mzilon/Elder-Care-AI/README.md

# Elder-Care-AI
The project files are constantly being revised and uploaded here.
A Quick Demo: https://youtu.be/ah3b0XdRygE
