mzilon/Elder-Care-AI/Kick-off Presentation.pdf

# Nala: Smart Companion for Seniors

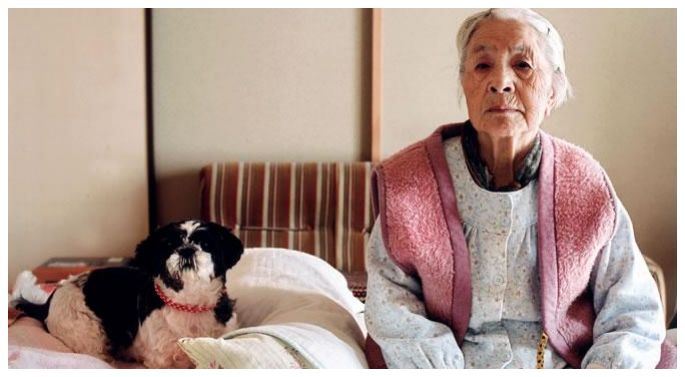
[picture p55: figure]
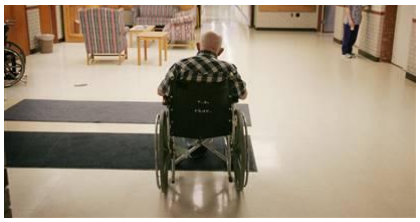
[picture p56: figure]
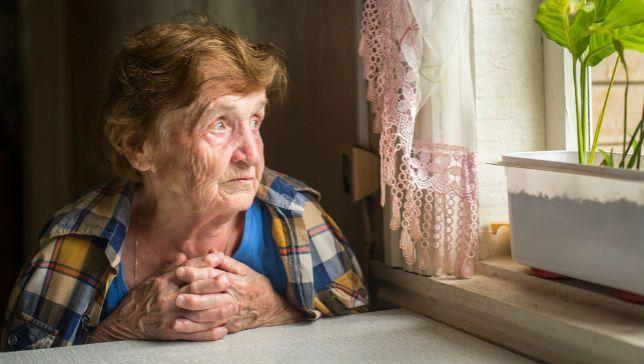
[picture p57: figure]

TEAM: Randy Garcia (Project Manager), Thomas Wilk, Hongyu Shi, Mohammad Zilon, Parmanand Shiwmangal MENTOR: Professor Xiao

# Chapter 1: Introduction

- The idea of smart companion for seniors resonated with us
- Nala is a smart companion for seniors which helps improve the

lives of its users

- The device will be small so that it can fit comfortably in a home

and also be pleasant or cute in appearance

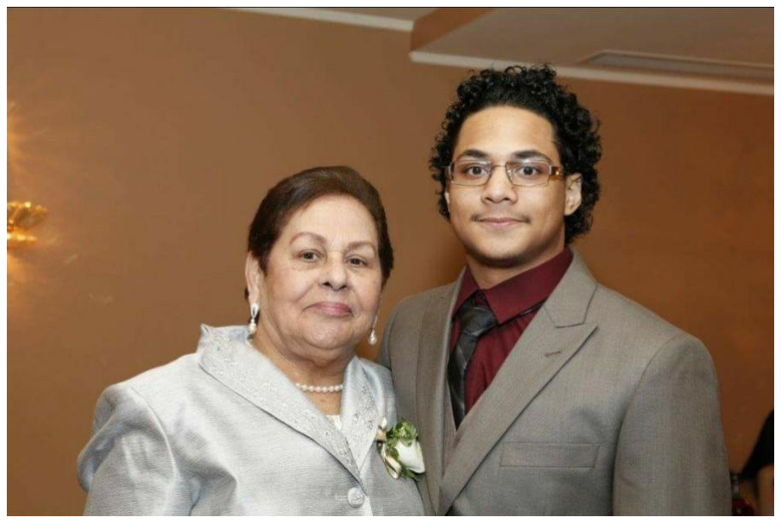
[picture p58: figure]

Image I: Randy wants his grandmother to have all the

support she can get

# Need

- Seniors have become a fast-growing share of the U.S. population. According to projections from the Population Reference Bureau, nearly one in four Americans will be over 65 by 2060. (Source: U.S. Census Bureau)
- Most adults are out working, while their elderly parents are often left alone, or are at a senior care center where they might not be given adequate attention.

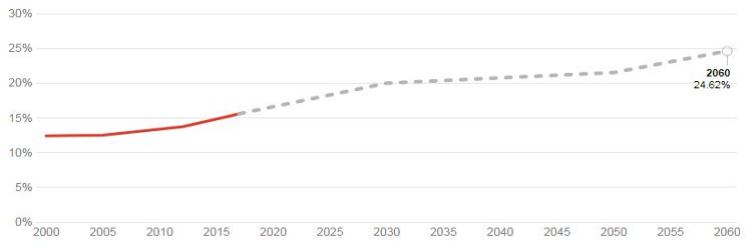
[picture p59: figure]

Need cont.

- Study conducted Selwyn Height retirement home in New Zealand.
- 40 seniors participated in the from ages ranging from 55-100 years.

### - Where a group of 20 interacted Paro for 12 weeks - Compared to the control group the group with Paro were noted to feel less lonely

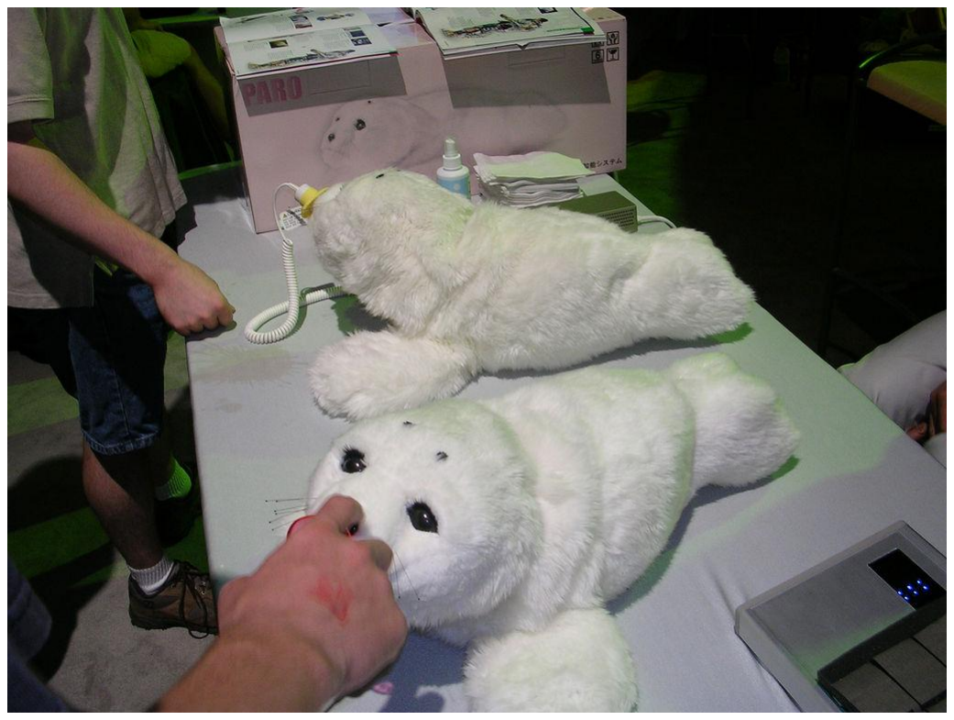
[picture p60: figure]

# Problem

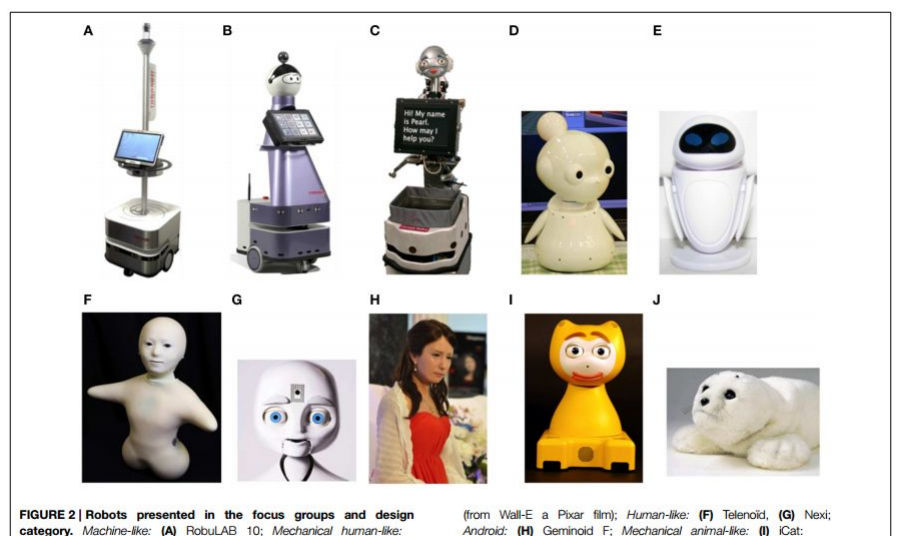
[picture p61: figure]

- The main problem addressed we will be companionship for the elderly.
- So a pleasant appearance, a comfortable size along with a natural way of interacting with our companion are all necessary help to alleviate those feelings of the user being lonely or perhaps forgotten
- The device will support its user by providing reminders, life

alert, and functions for fun. The machine-learning nature of the robot would allow it to create more useful alerts, reminders, and games.

# Business Model Canvas

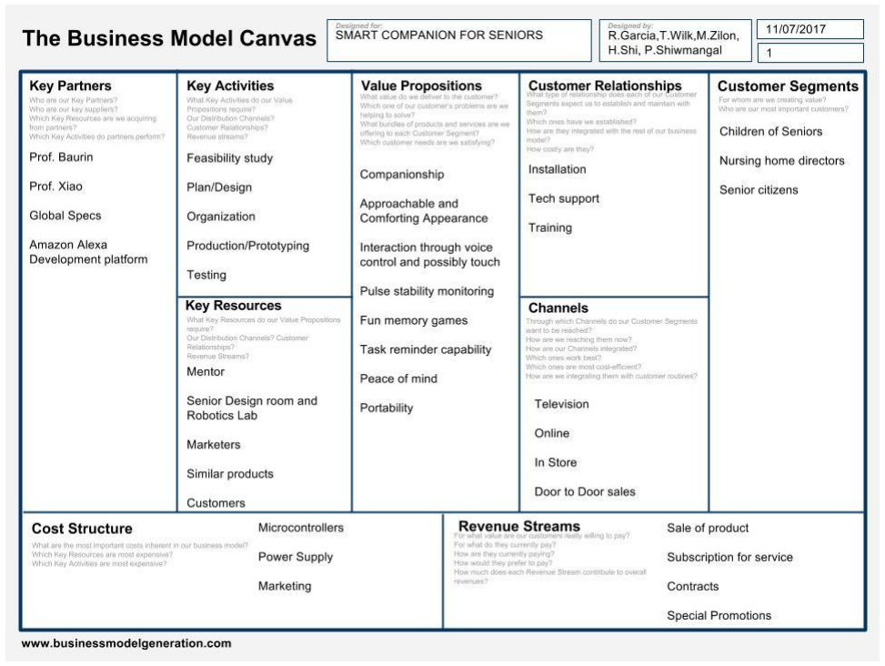
[picture p62: figure]

# External Requirements

Nala’s key external requirements are its functions, safety, operating environment, appearance, robustness and reliability.
Key Functions:
- Companionship (Note it does not replace human companionship),
- Life stability monitoring,
- Task reminding,
- Memory games,
- Motion to aid in appearance and interaction.

The Operating Environment:
- At room temperature of about 20℃ or 68℉ or 293°K.
- To be used indoors such as private homes and nursing homes, though it can be utilized outdoors.
- To be used in stationary condition, such as on top of desks or tables.

External Requirements cont.

Appearance:
- Friendly, approachable, comforting and soothing.

Robustness:
- Internal circuitry protected by metal framework.
- External body encased in polymer.

Reliability:
- Supported by emergency batteries in case there is loss of AC power.
- Nala’s functionality is not dependent on its physical condition. Therefore, its functionality will not degrade even if it is physically damaged.

# Internal Requirements

Marketing

- Phone interviews and face-to-face interviews have been conducted with potential customers to gain insight of their experiences with senior care products, such as devices to keep patients occupied and other unmet needs that can be offered by a companion bot.
- Adults ages 50 to 65 who are providing active care to their elderly parents ages 70 and beyond.
- Ideally receive a government contract requiring our device be installed in all federal and state veteran’s hospitals.

Internal Requirements cont.

Manufacturing

- Essential Parts to be Ordered:
1. 3D printing Filaments,
2. Raspberry Pi 3,
3. Arduino Uno,
4. Bluetooth Pulse Sensor,
5. Stereo Camera,
6. A microphone,
7. 5V Voltage Regulator
8. Continuous Rotation Servos.
- We have options to assemble and test the companion bot in in a studio space in NYC or in Professor Xiao’s Lab Room.

# Restrictions

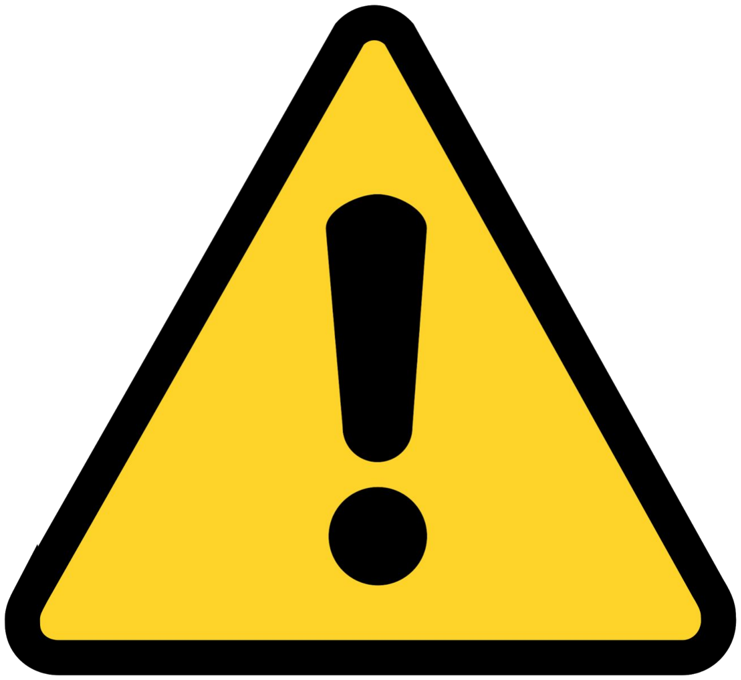
[picture p63: figure]

### - Patent: exists for robotic system to “assist immobile persons”

### - Institutions: respect for others

### - Insurance: UL certification would be need for final product

# Limitations: Environmental limitations affecting the product

### Conductive surfaces insulated

### Voltage regulator to isolate internal parts from wall

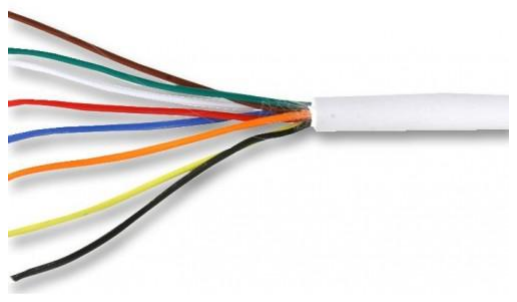
[picture p64: figure]

### voltage

### Air circulates through device body for natural cooling

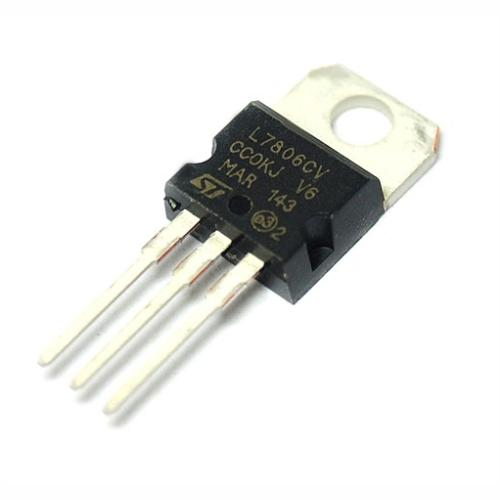
[picture p65: figure]
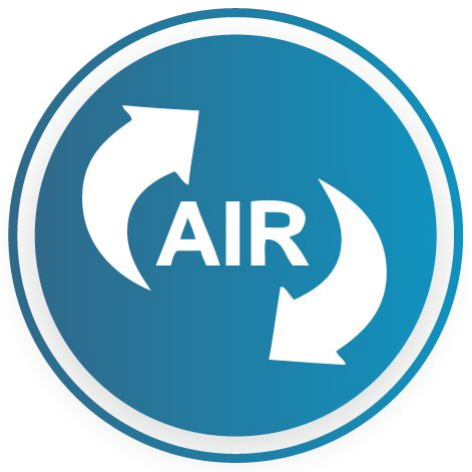
[picture p66: figure]

# Limitations: product affecting the environment

Creates no solid waste | Creates no air pollution | Noise pollution: headphones can be used

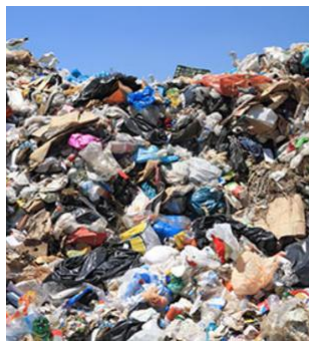
[picture p67: figure]
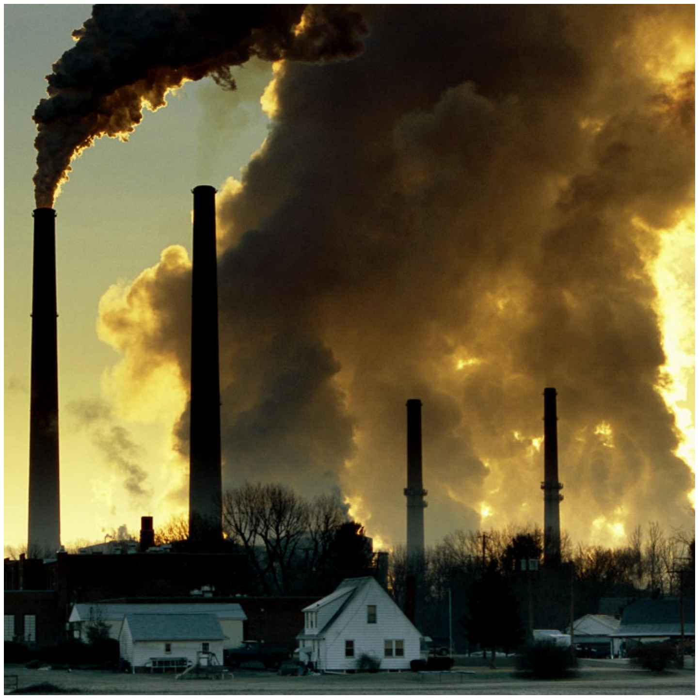
[picture p68: figure]
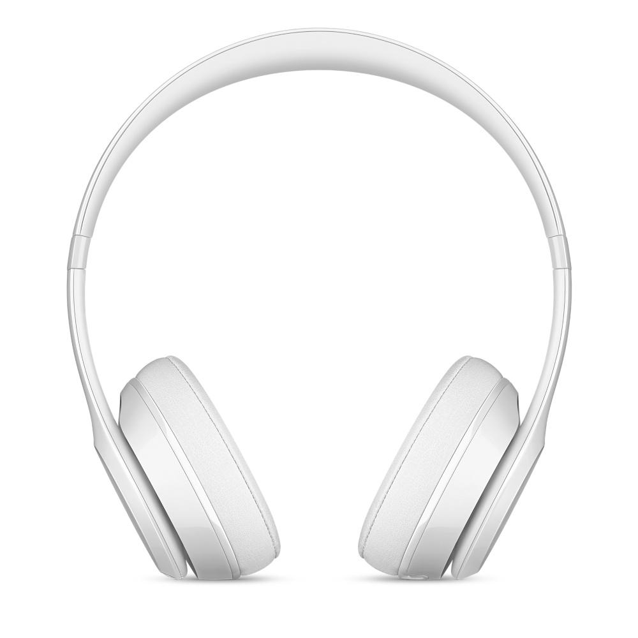
[picture p69: figure]

# Project Charter

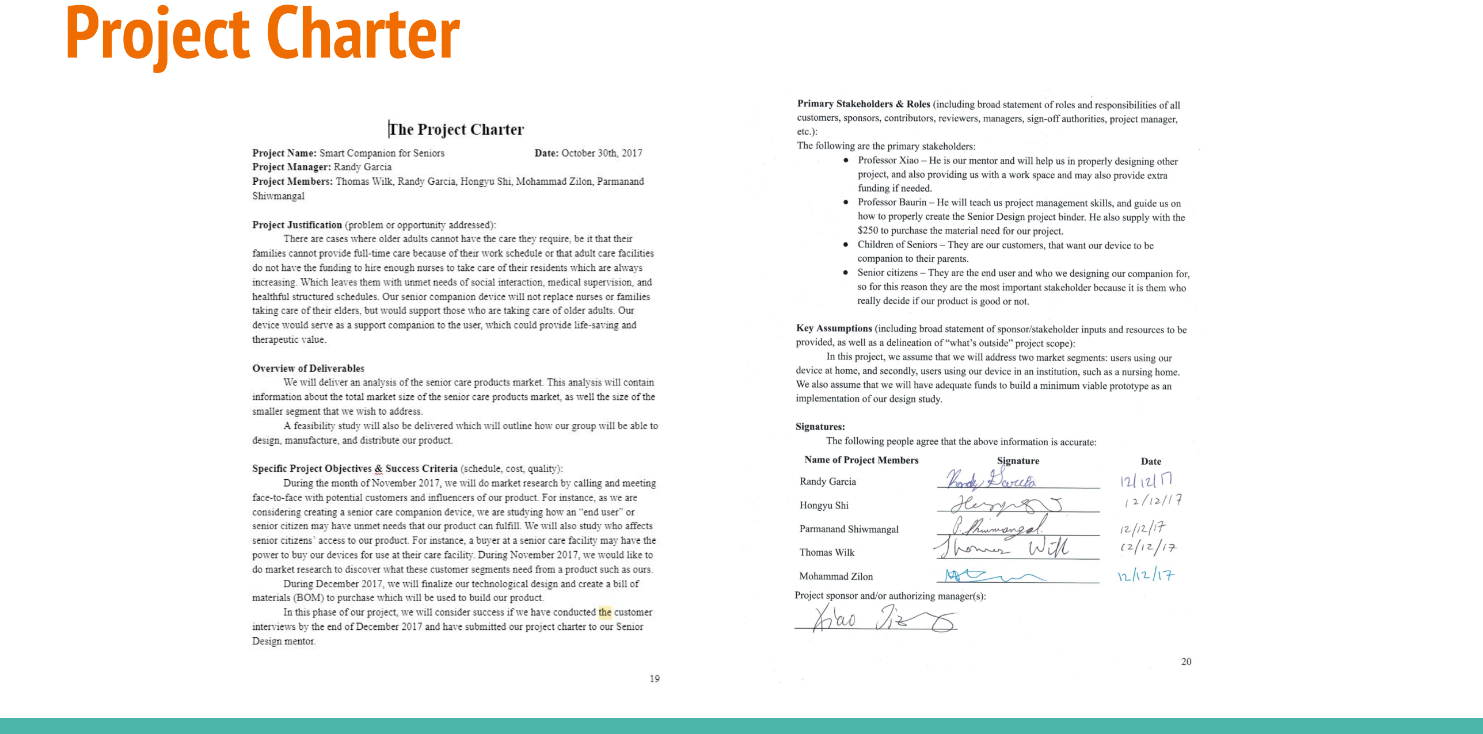
[picture p70: page 14]

# Chapter 2: Planning

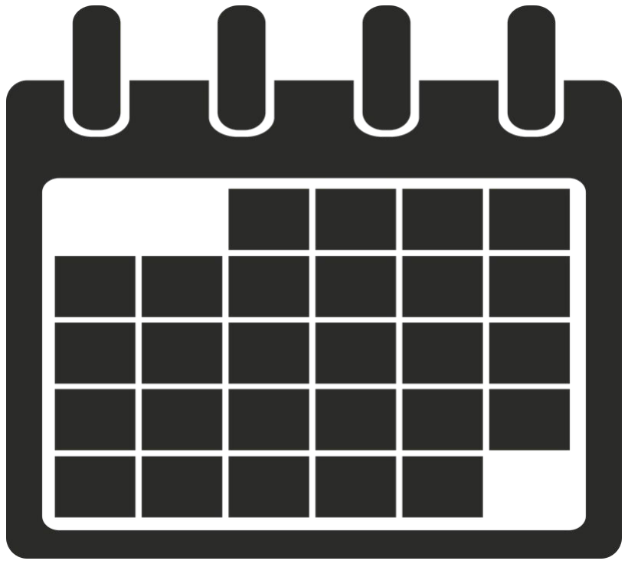
[picture p71: figure]

“If you fail to plan, plan to fail.” -- Benjamin Franklin

# Project Justifications

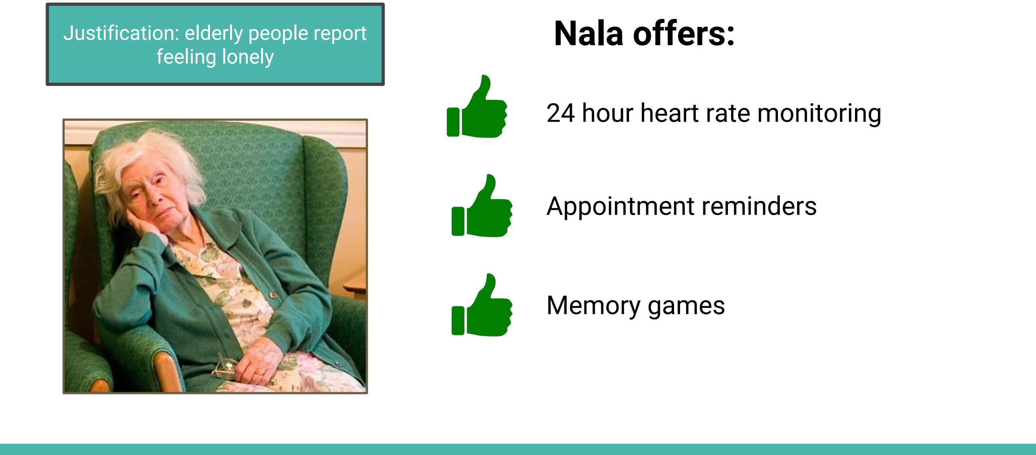
[picture p72: figure]
Justification: elderly people report feeling lonely; 24 hour heart rate monitoring; Appointment reminders; Memory games; Nala offers:

# Project Deliverables

1. Scope | 2. | WBS | 3. Activities
4. | Network Diagram | 5. | GANTT Chart | 6. Budget
7. BOM

# Scope Management Plan

## Out of scope:

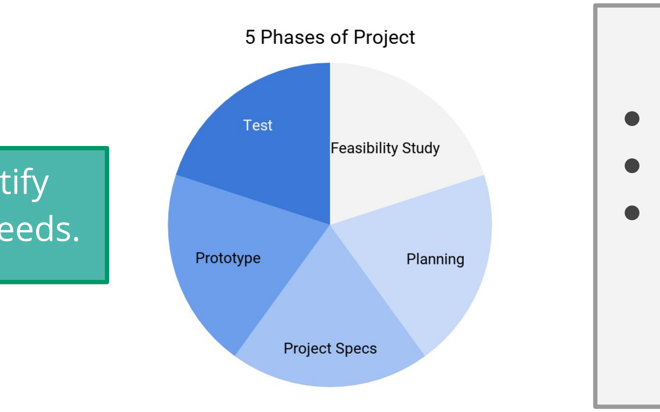
[picture p73: figure]

## - UL Certification - Customer testing - Obtain license or insurance for product use

## In scope: Identify

unmet market needs.

# Bill of Materials

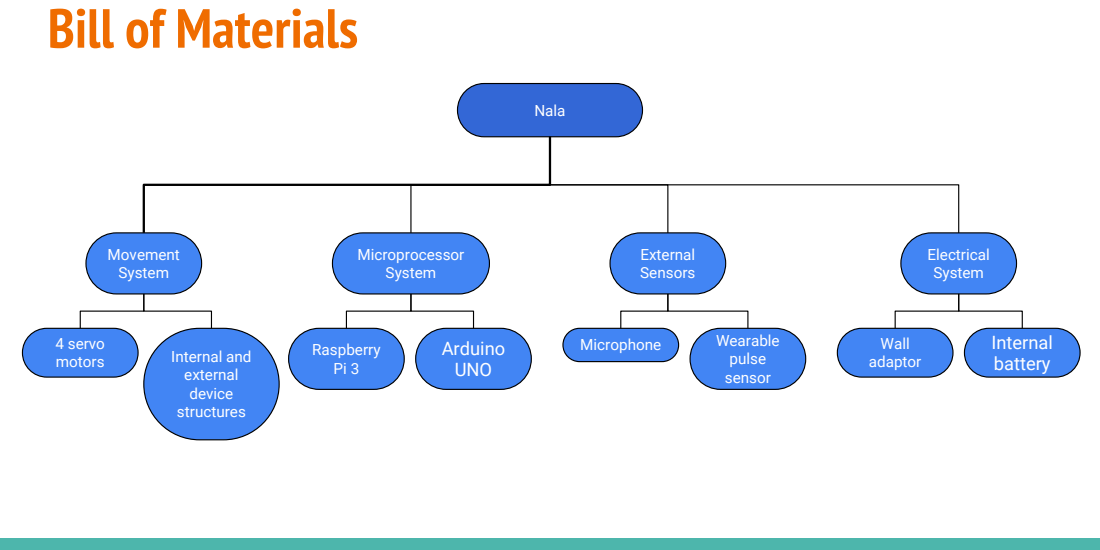
[picture p74: page 19]
Nala; Microprocessor System; Movement System; 4 servo; motors; Internal and; external device structures; Raspberry Pi 3; Arduino UNO; External Sensors; Microphone; Wearable; pulse sensor; Electrical System; Wall adaptor; Internal battery

# Work Breakdown Structure

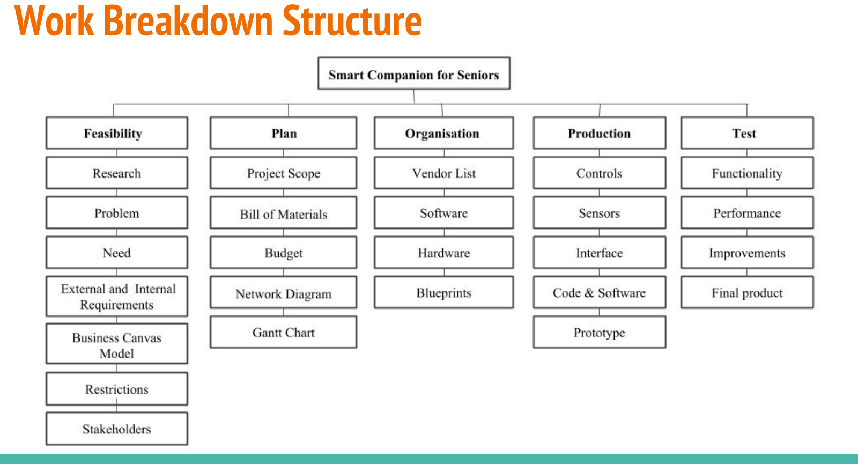
[picture p75: page 20]

# List of Activities: An example

Business Model Canvas

1) Attend the Business Model Canvas Lecture
2) Research the Business Model Canvas and find template
3) Use the previous written section to fill out template
4) Review
5) Print and bind

# Network Diagram: Summary

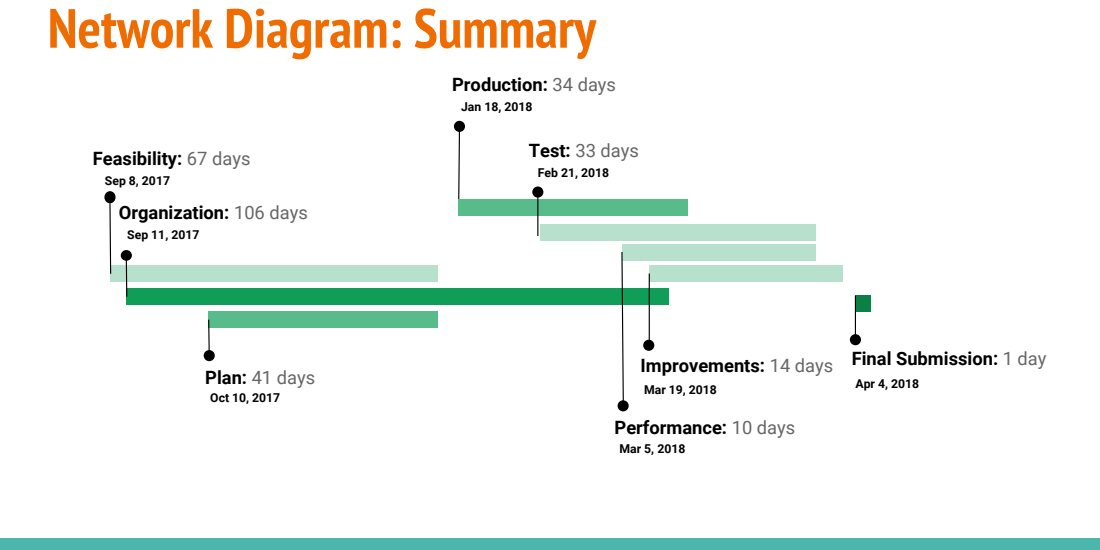
[picture p76: page 22]
Sep 8, 2017; Feasibility: 67 days; Sep 11, 2017; Organization: 106 days; Oct 10, 2017; Plan: 41 days; Jan 18, 2018; Production: 34 days; Apr 4, 2018; Feb 21, 2018; Test: 33 days; Mar 5, 2018; Performance: 10 days; Improvements: 14 days; Mar 19, 2018

Final Submission: 1 day

# Gantt Chart: A Snapshot

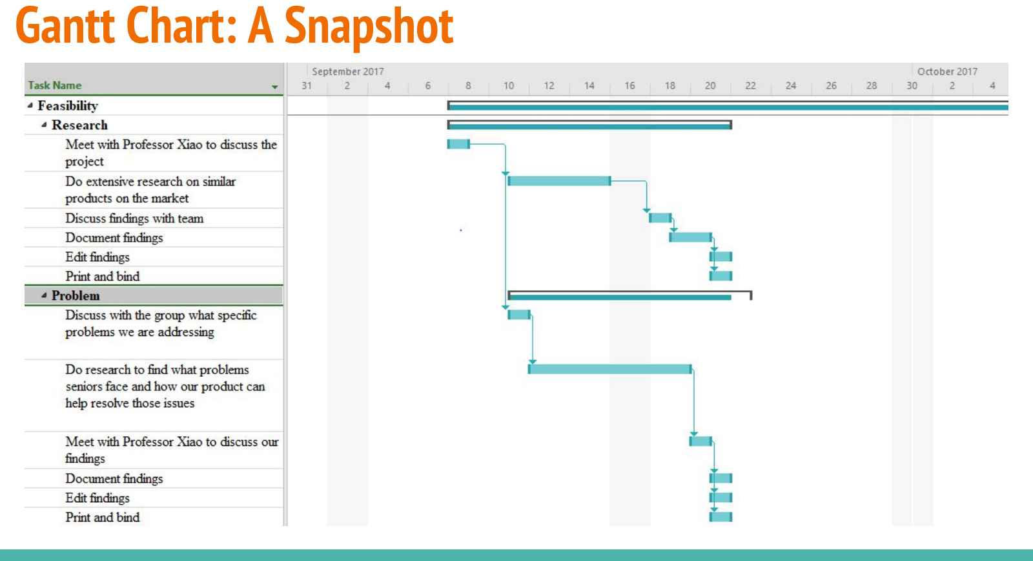
[picture p77: page 23]

# Budget

# Senior Design Funding: $250.00 Project Mentor Funding: as requested

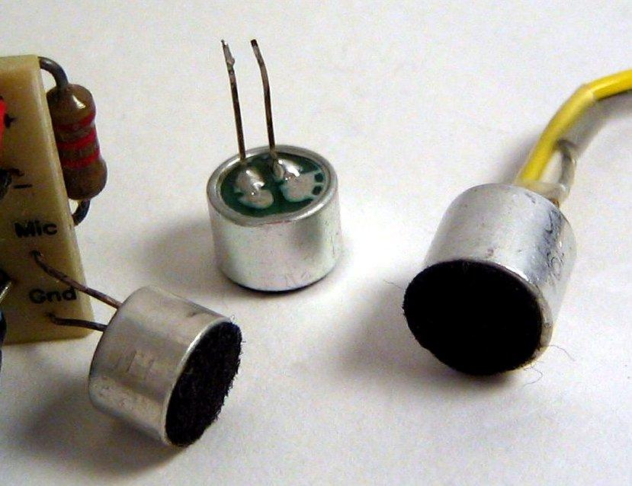
[picture p78: figure]
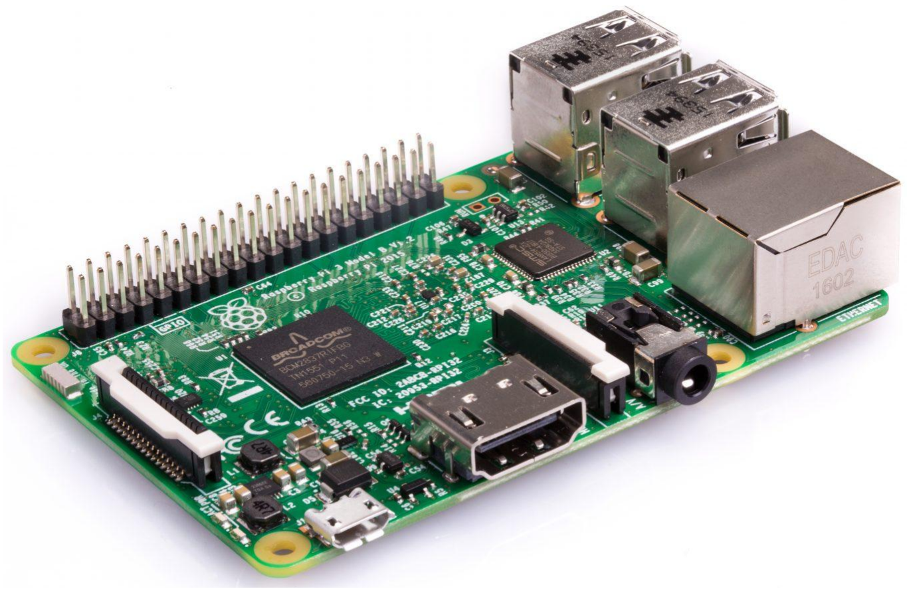
[picture p79: figure]
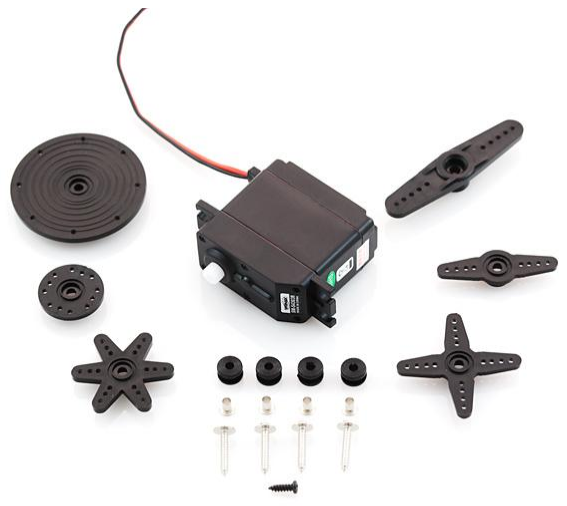
[picture p80: figure]
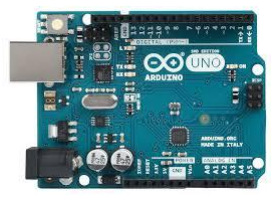
[picture p81: figure]

$35.00 | $22.00 | $20.00 | $0.82

# Chapter 3: Vendor List

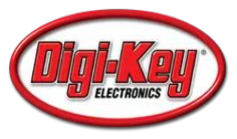
[picture p82: figure]

- Arduino Uno
- Raspberry Pi 3
- Pan and Tilt Kit with
Servos
- Continuous Rotation
Servos
- Electret Microphone

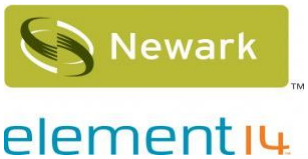
[picture p83: figure]

- Arduino Uno
- Raspberry Pi 3
- Speaker
- Lithium Polymer Battery
Packs

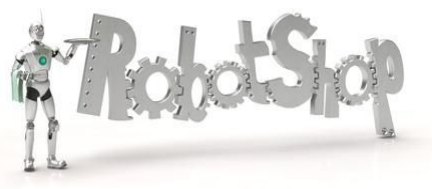
[picture p84: figure]

- Pan and Tilt Kit with
Servos
- Continuous Rotation
Servos
- Electret Microphone

Vendor List cont.

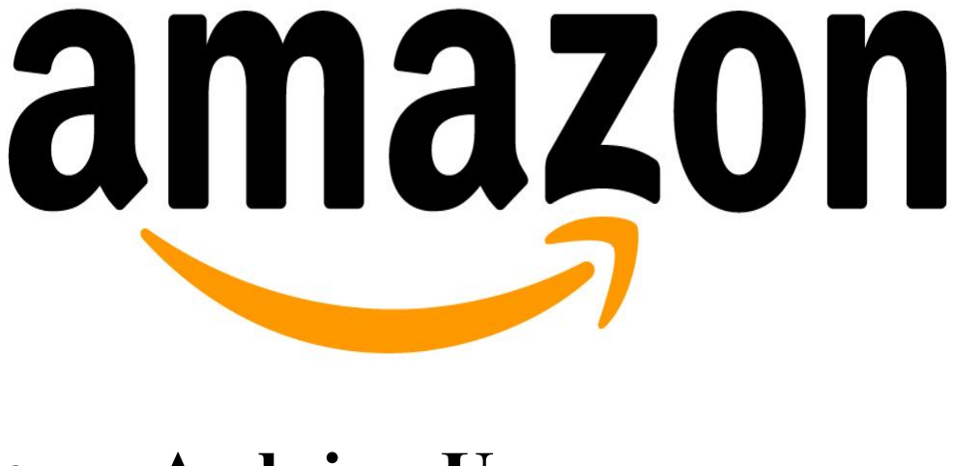
[picture p85: figure]

- Arduino Uno
- Raspberry Pi 3
- Pan and Tilt Kit with
Servos
- Continuous Rotation
Servos
- Bluetooth Pulse Sensor
- Interface Modules
Rechargeable 5V Lipo
USB Boost

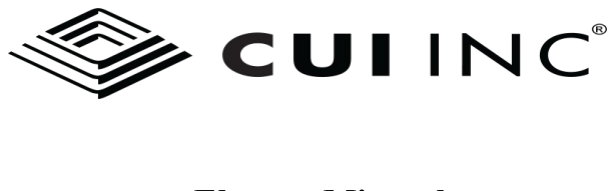
[picture p86: figure]

- Electret Microphone

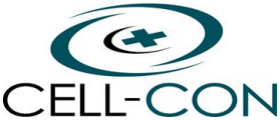
[picture p87: figure]

- Lithium Polymer
Battery Packs

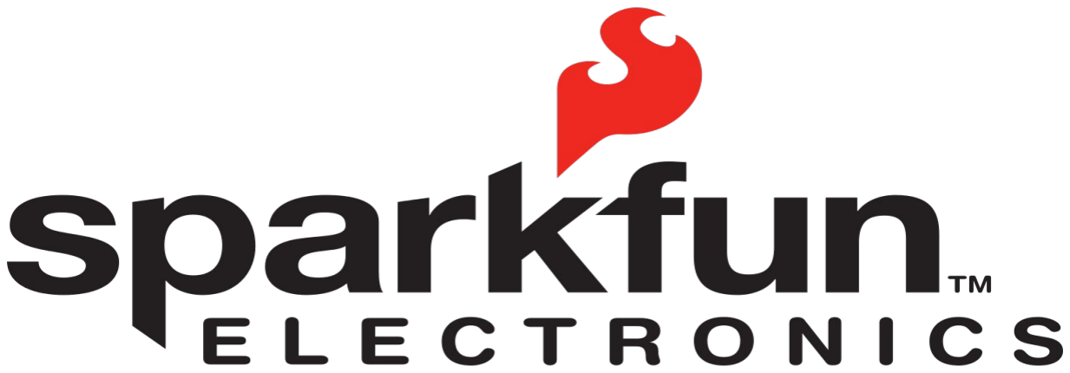
[picture p88: figure]

- Interface Modules
Rechargeable 5V Lipo USB
Boost
- Lithium Polymer
Battery Packs
