mzilon/Elder-Care-AI/Final Presentation 2018.pdf

# Nala: Smart Companion for Seniors

TEAM: Randy Garcia (Project Manager), Hongyu Shi, Parmanand Shiwmangal,

## Thomas Wilk, Mohammad Zilon MENTOR: Professor Xiao

# Introduction

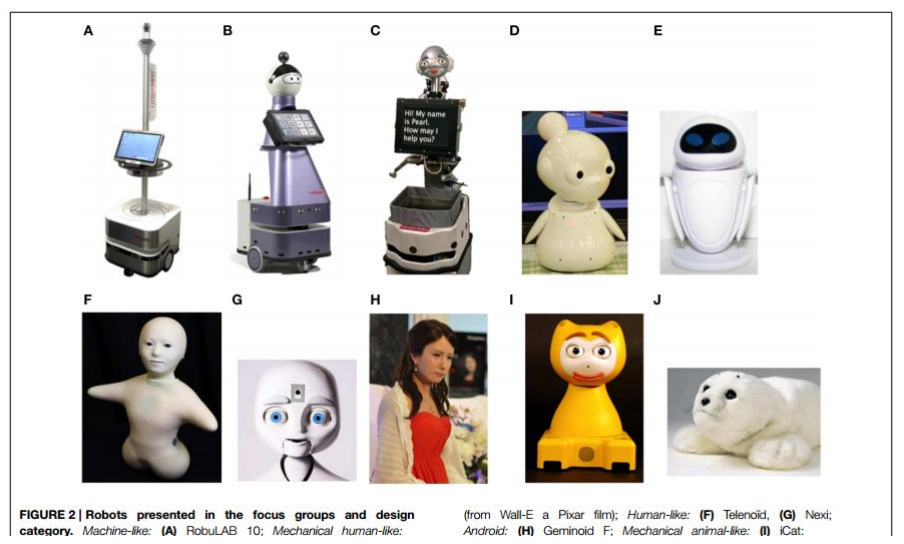
[picture p89: figure]

- We want to provide support for older adults and

family members

- Nala will support its user by providing reminders, life alert, and functions for fun.
- A pleasant appearance, a comfortable size, and a natural way of interacting with our the user are all necessary to help relieve isolation.

# Problem

- Seniors have become a fast-growing share of the U.S. population. According to projections from the Population Reference Bureau, nearly one in four Americans will be over 65 by 2060. (Source: U.S. Census Bureau)
- Most adults are out working, while their elderly parents are often left alone, or are at a senior care center where they might not be given adequate attention.

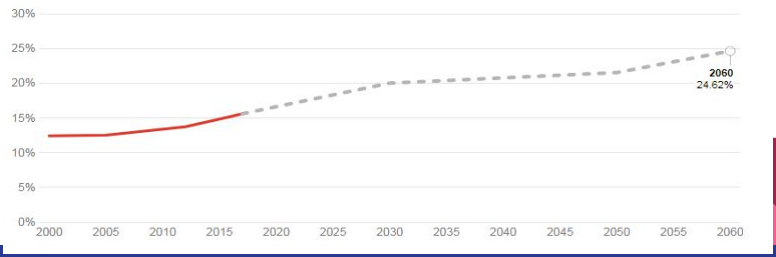
[picture p90: figure]

Problem cont.

- Study conducted Selwyn Height retirement home in New Zealand.
- 40 seniors participated in the from ages ranging from 55-100 years.

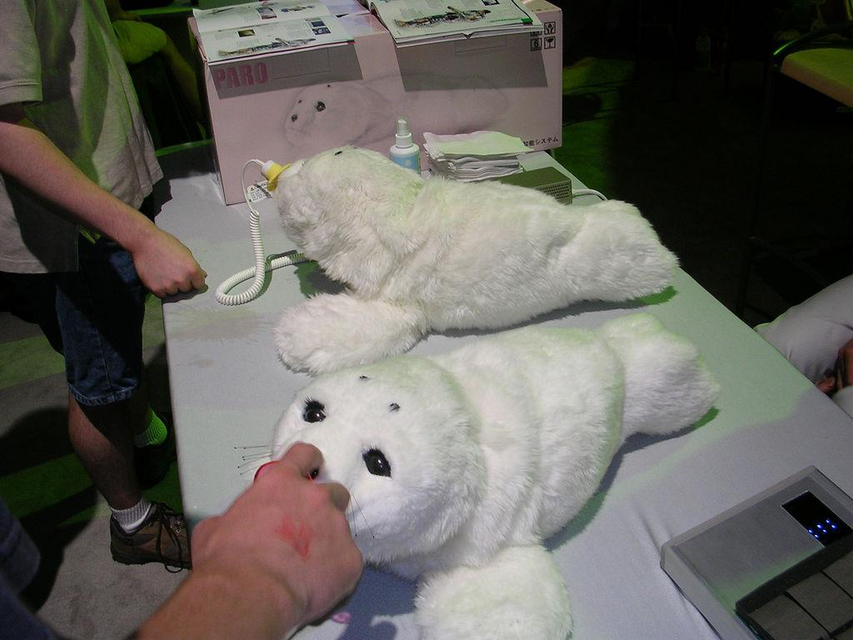
[picture p91: figure]

- Where a group of 20 interacted Paro for 12 weeks
- Compared to the control group the group with Paro were noted to feel less lonely

# 3D Design: pleasant, cute, fun

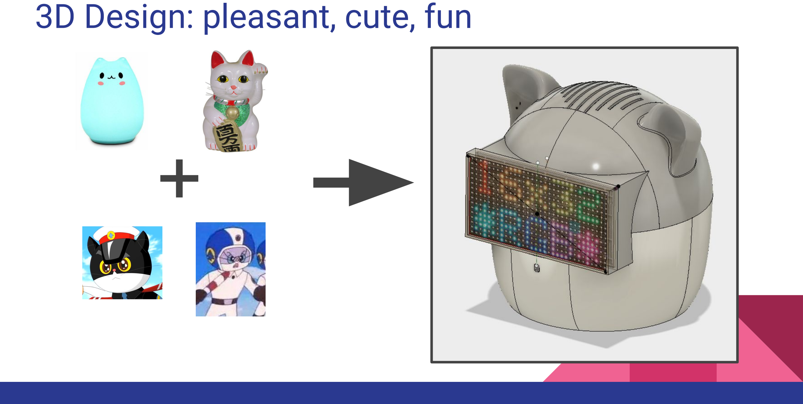
[picture p92: page 5]

+

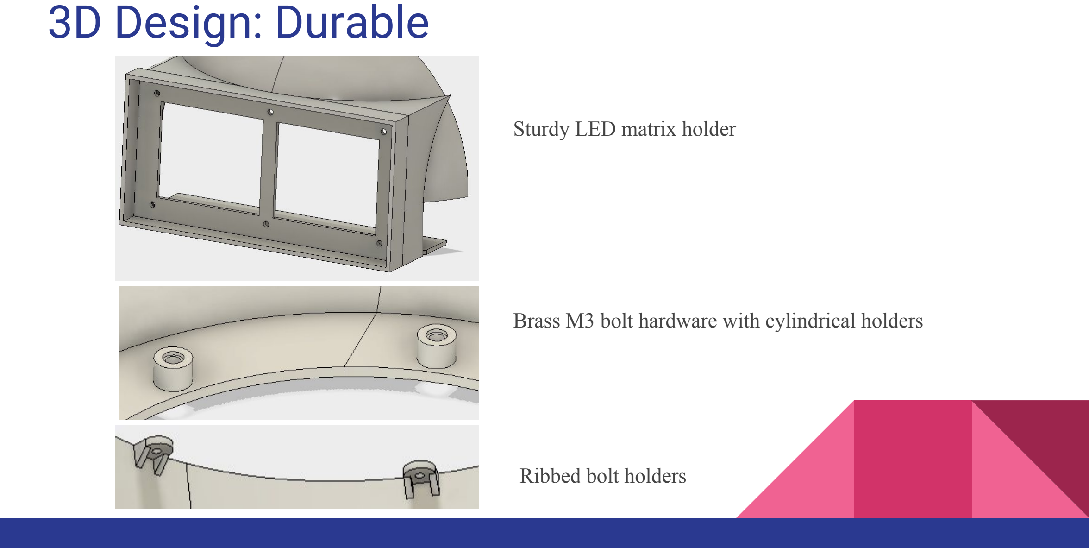
[picture p93: figure]
3D Design: Durable; Ribbed bolt holders; Sturdy LED matrix holder

Brass M3 bolt hardware with cylindrical holders

# 3D Design: ease of use

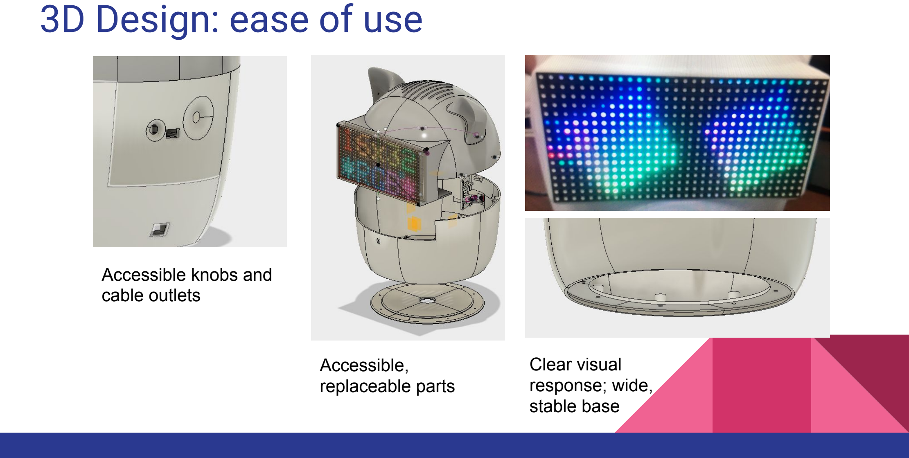
[picture p94: page 7]

Accessible,
replaceable parts

Accessible knobs and
cable outlets

Clear visual
response; wide,
stable base

# Electrical System

Block diagram showing major components and general flow within Nala

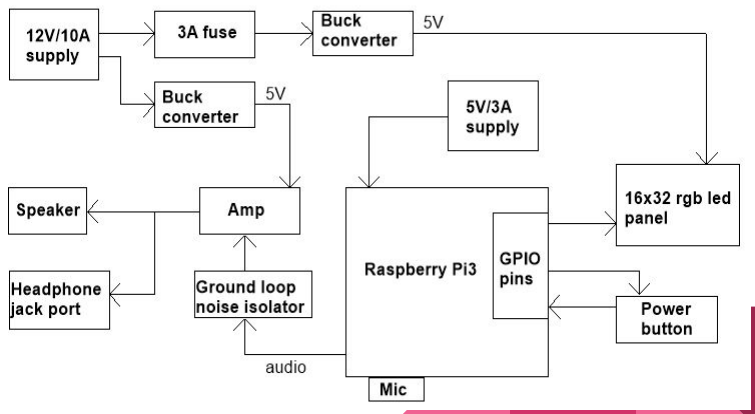
[picture p95: figure]

Components:
- Researched
- Purchased
- Tested
- Wired accordingly

Electrical System cont.

Nala’s Interior Components:

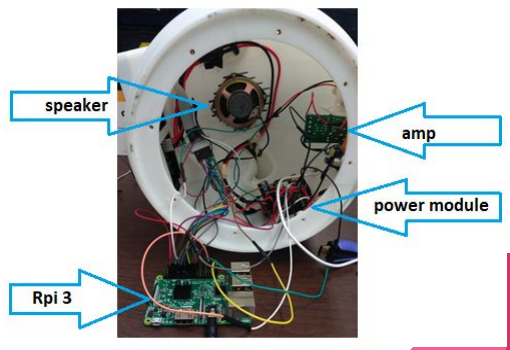
[picture p96: figure]

Electrical System cont.

Major Problem: Loud hum/buzz from speaker

Cause:
- Using audio in conjunction with LED panel.
- Both features require the use of pulse width modulation module in RPi.
- Also power supply noise

Solution:
- Grounding unused GPIO GND pins of RPi.
- Use of ground loop noise isolator on RPi audio output.
- Decoupling capacitor across power supply line (+ve to -ve).

Result: Very low hum/buzz from speaker

# Onboard Computations on the Raspberry Pi

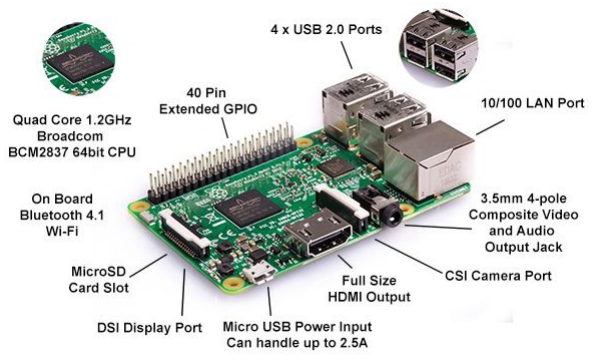
[picture p97: figure]

Raspberry Pi is a credit-card sized computer.

The Raspberry Pi handles the onboard computations:

- Alexa Voice Service
- Drives the the speaker.
- Controls the 16x32 RGB LED Matrix.
- Runs a boot script to automate various processes such as activivating Alexa, initiating the speaker, power button and display.

# Pi Controls The LED Matrix via its GPIOs

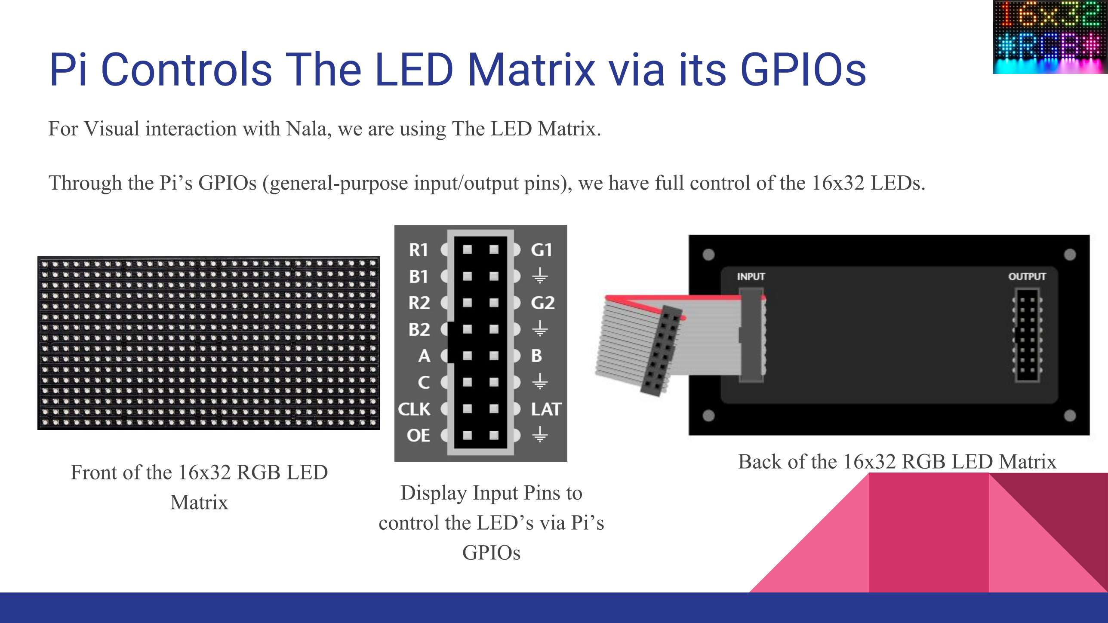
[picture p98: page 12]

For Visual interaction with Nala, we are using The LED Matrix.

Through the Pi’s GPIOs (general-purpose input/output pins), we have full control of the 16x32 LEDs.

Display Input Pins to
control the LED’s via Pi’s GPIOs

Front of the 16x32 RGB LED Matrix

Back of the 16x32 RGB LED Matrix

Pi Controls The LED Matrix via its GPIOs cont.

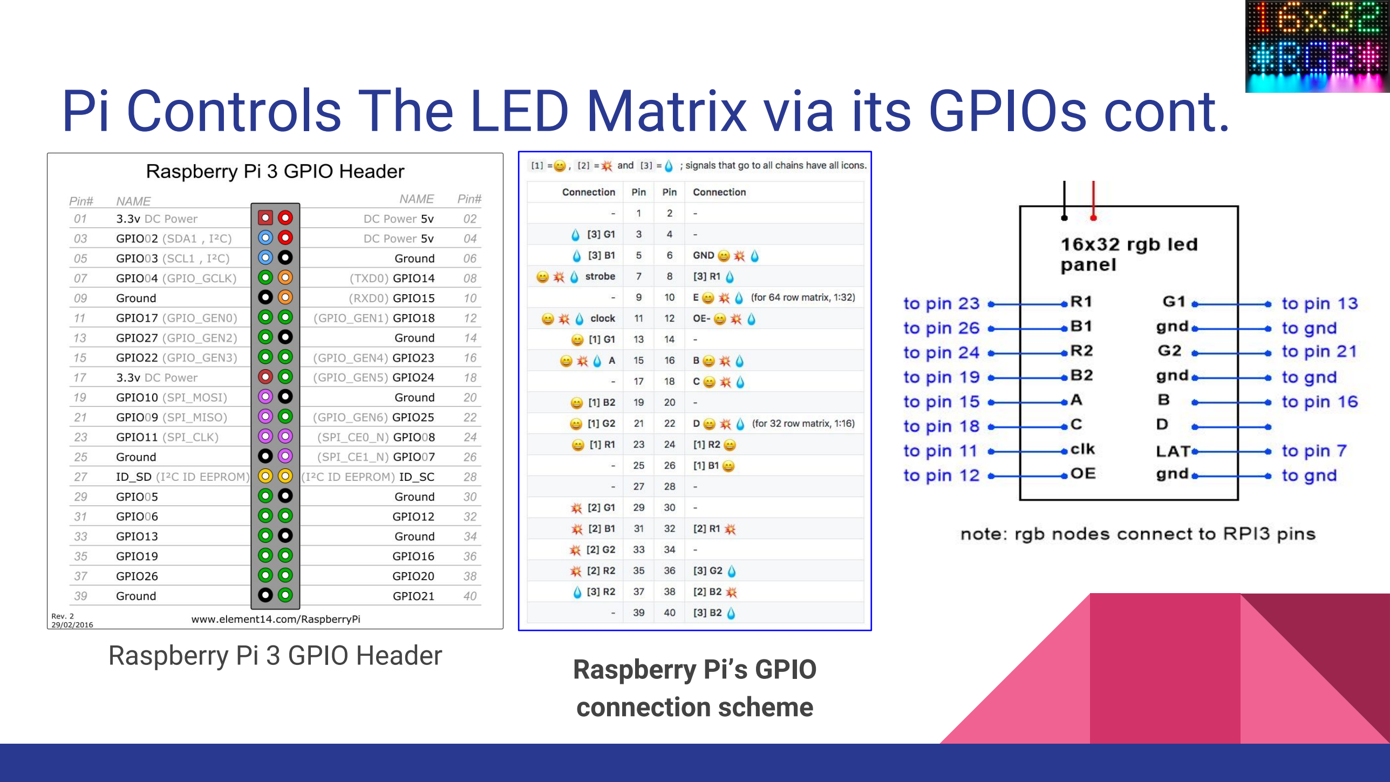
[picture p99: page 13]

Raspberry Pi 3 GPIO Header | Raspberry Pi’s GPIO
| connection scheme

Pi Controls The LED Matrix via its GPIOs cont.

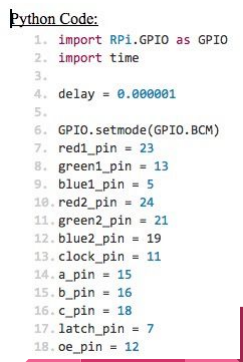
[picture p100: figure]

Controlling the LED Panel via Python or C/C++ Code:
The Display can be controlled by one simple python code.

C/C++ Code:
To use the C code, this Hzeller’s Git [https://github.com/hzeller/rpi-rgb-led-matrix] has to be downloaded and be made on the Pi. The instruction are on the readme.md file.

Running Commands:
After the making the “Demo” file, we can run various demos. For example to run a rotating square script we have to run the following command via the Pi’s Terminal app. “sudo ./demo -D0 --led-no-hardware-pulse --led-cols=32 --led-rows=16 --led-chain=1 --led-brightness=50”

There is also an API to create a program to display an image or video. The link to the API is https://github.com/hzeller/rpi-rgb-led-matrix/tree/master/utils.

# Display’s Capabilities

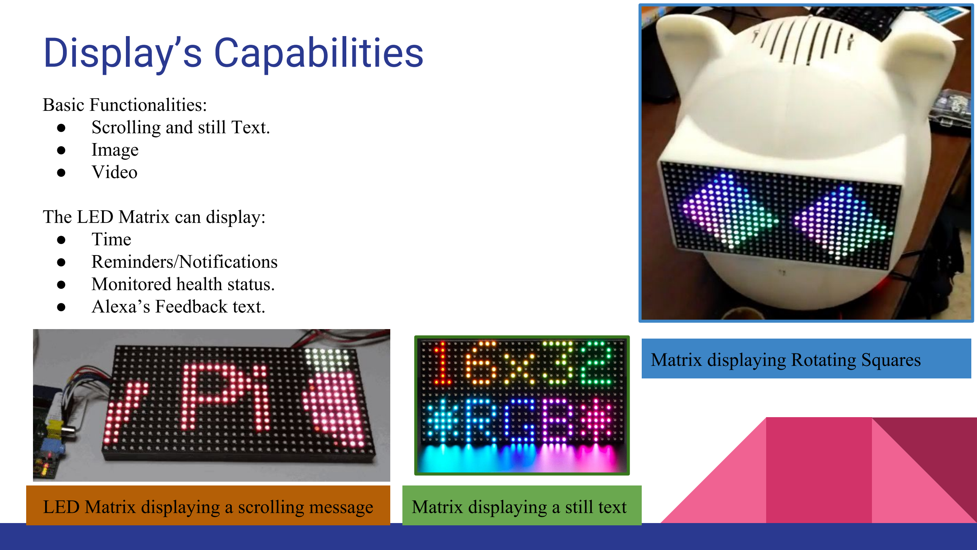
[picture p101: page 15]

LED Matrix displaying a scrolling message

Matrix displaying Rotating Squares

Matrix displaying a still text

Basic Functionalities:
- Scrolling and still Text.
- Image
- Video

The LED Matrix can display:
- Time
- Reminders/Notifications
- Monitored health status.
- Alexa’s Feedback text.

# Making Nala “Smart”: Alexa Voice Service

Alexa Voice Service (AVS) is Amazon's suite of
services built around its voice-controlled AI assistant for the home and other environments. Amazon provides access to its machine learning algorithms, which are freely available as application programming interfaces (APIs). We used these APIs in Nala’s routines to allow Nala to learn to respond in a more natural way. In this way, the more time a user spends with Nala, the more Nala can respond in an engaging way with the user, and provide therapeutic benefits.

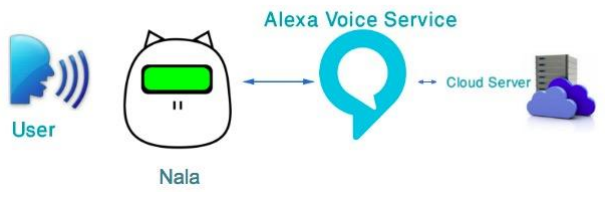
[picture p102: figure]

Figure #: Block diagram describing Alexa’s use with Nala

Alexa Voice Service cont.

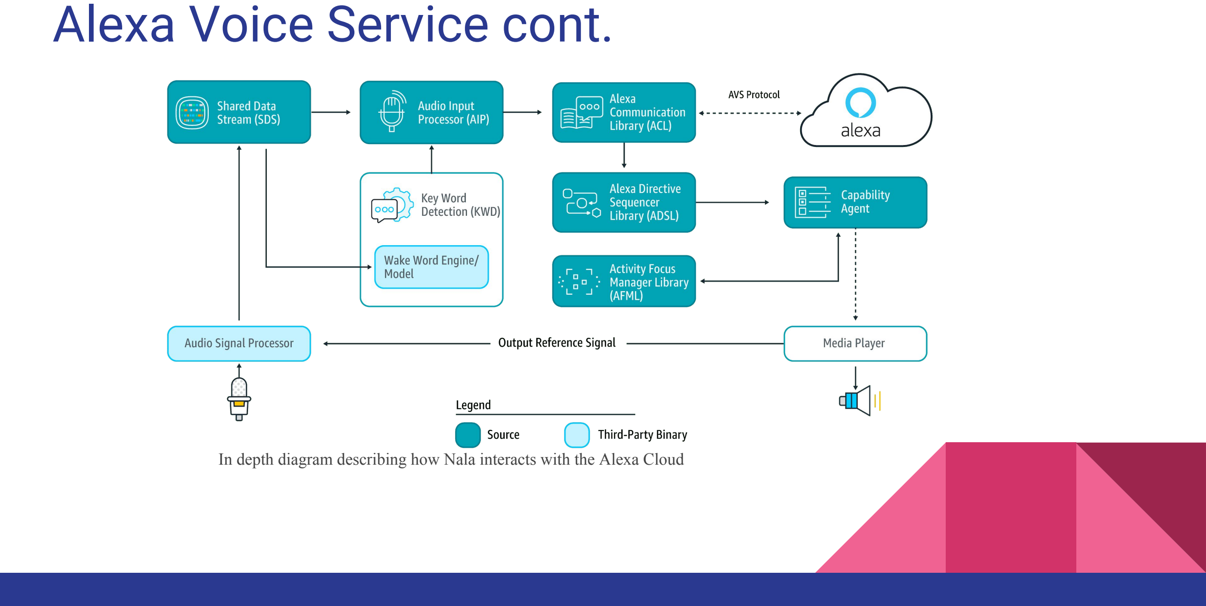
[picture p103: page 17]

In depth diagram describing how Nala interacts with the Alexa Cloud

# Alexa Web Service (AWS)

- Amazon Web Service is a service that Amazon provides on demand cloud computing platforms for user to use on a paid subscription basis.
- The Alexa Skill Kit is a collection of self-service APIs and tools that makes it easy for you to create new voice-driven capabilities for Alexa.
- The code for the Skills are uploaded to AWS lambda which then executes the code.

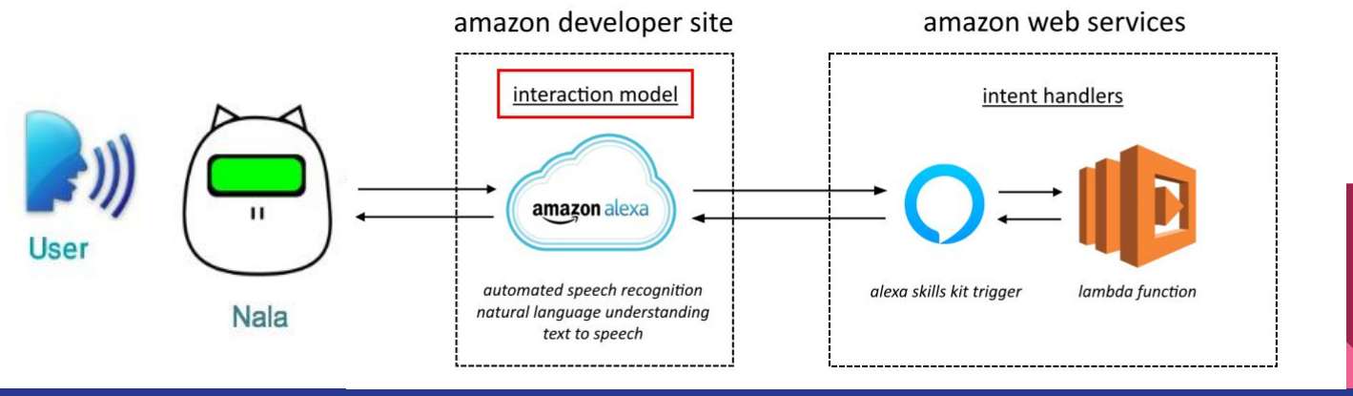
[picture p104: figure]

# Skills

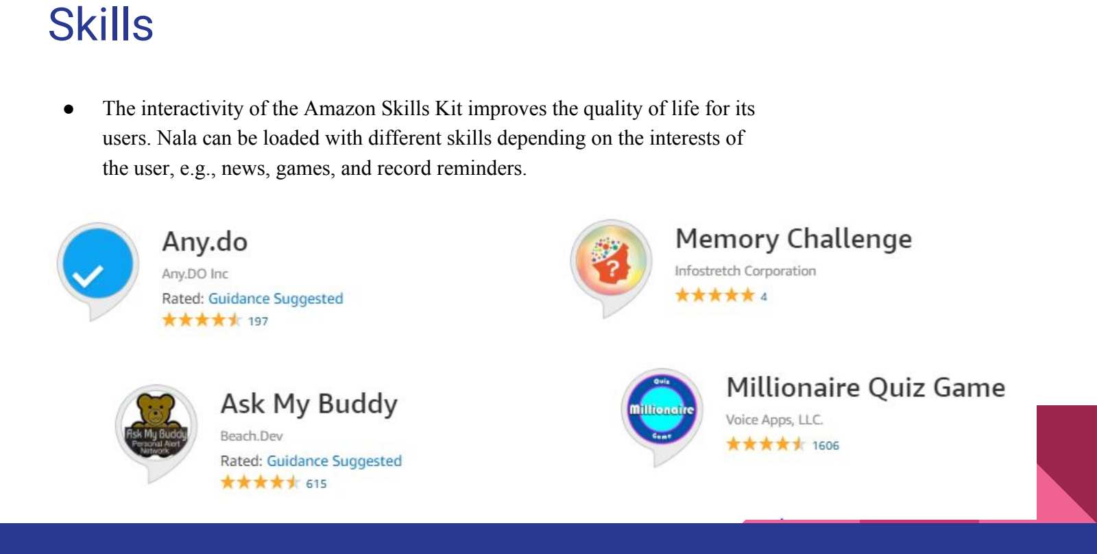
[picture p105: page 19]

- The interactivity of the Amazon Skills Kit improves the quality of life for its users. Nala can be loaded with different skills depending on the interests of the user, e.g., news, games, and record reminders.

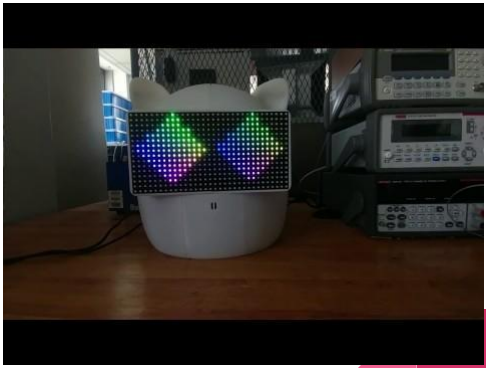
[picture p106: figure]

# Results

Demonstration Video using Nala

# Conclusion

The goals of the project were achieved. We created a cute, user-friendly, therapeutic, and interactive companion robot for the elderly. In a future phase of the project, the following improvements could be made:

- Incorporating a pulse band with Nala to monitor the user’s vital signals, and sending necessary alerts in case of emergencies.
- Allowing Nala to control smart home devices such as lights, security systems, air conditioning units, and thermostats.
- Adding motors/drivers to enable physical motion.
- Modifying the current body shape to meet user needs.
