mzilon/Elder-Care-AI/Quick Access to some Datasheets/speaker.PNG

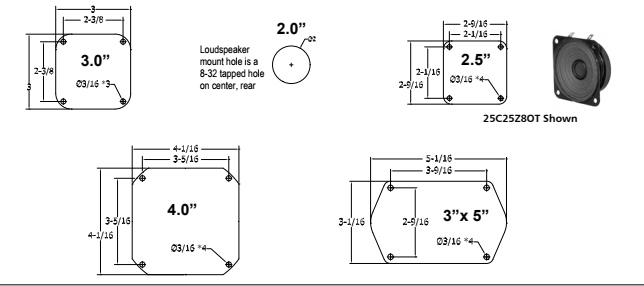
Quick Access to some Datasheets/speaker.PNG
