mzilon/Elder-Care-AI/3D Model/bottom_front_center.stl

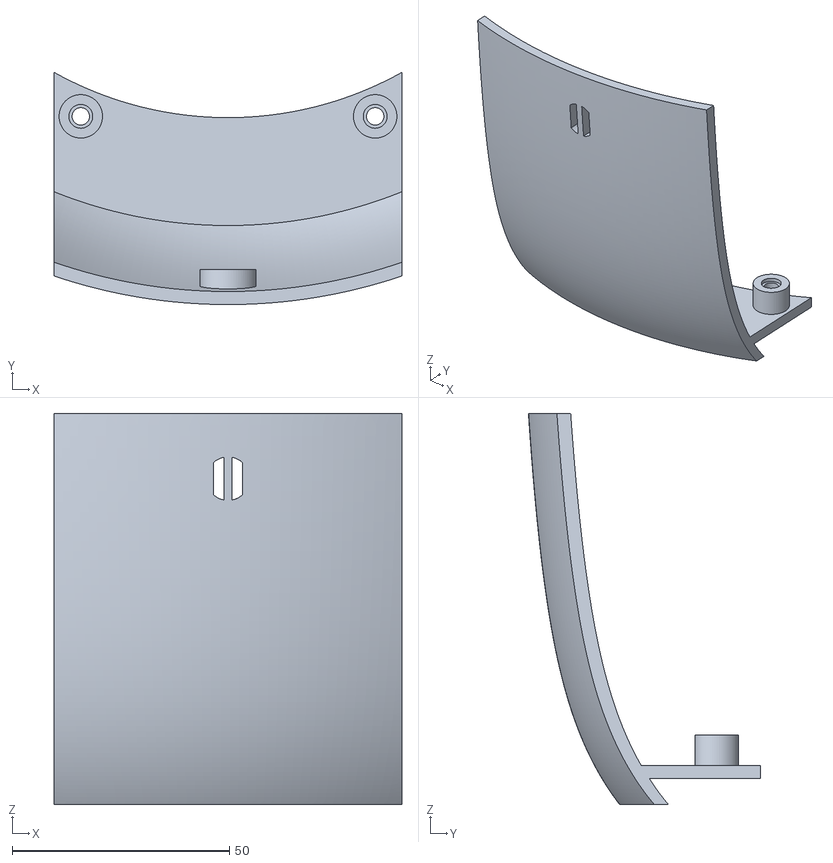
[picture p108: CAD file, 2018-05-24]
3D Model/bottom_front_center.stl
80.0 x 53.4 x 90.0
