mzilon/Elder-Care-AI/3D Model/top_back_mid_right.stl

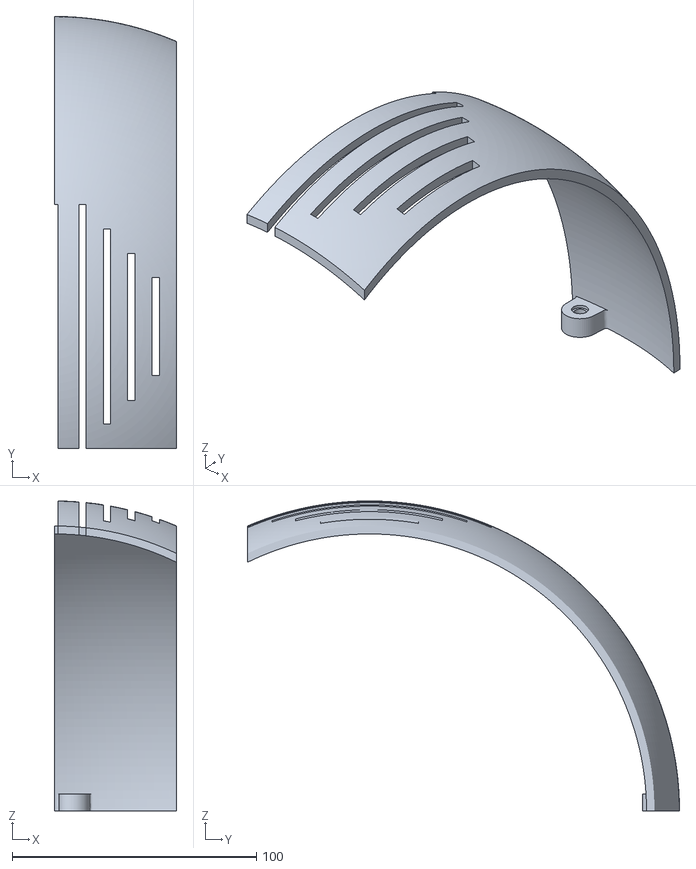
[picture p109: CAD file, 2018-05-24]
3D Model/top_back_mid_right.stl
50.0 x 177.0 x 127.0
