mzilon/Elder-Care-AI/3D Model/top_front_right.stl

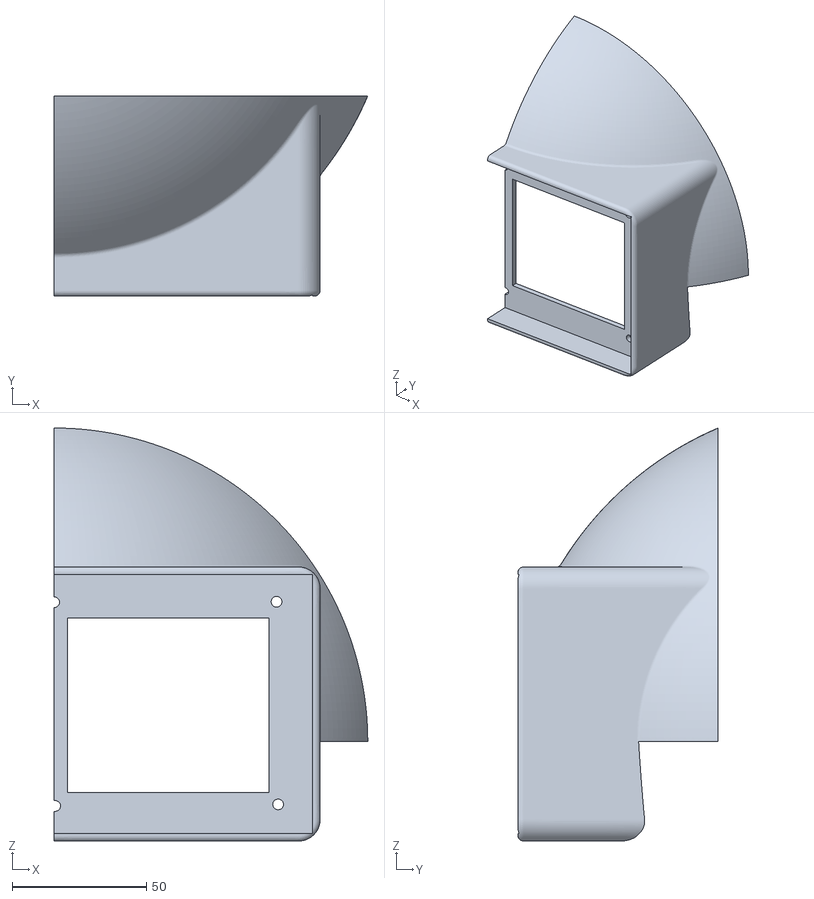
[picture p110: CAD file, 2018-05-24]
3D Model/top_front_right.stl
116.7 x 74.5 x 153.7
