mzilon/Elder-Care-AI/3D Model/bottom_back_left.stl

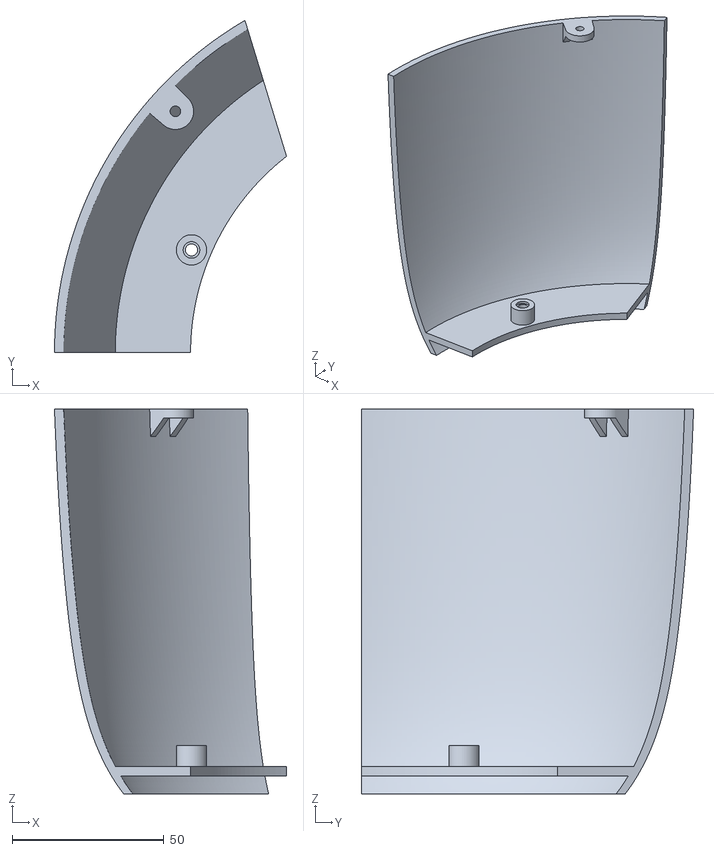
[picture p111: CAD file, 2018-05-24]
3D Model/bottom_back_left.stl
76.6 x 109.6 x 127.0
