mzilon/Elder-Care-AI/3D Model/10in_base_quarter.stl

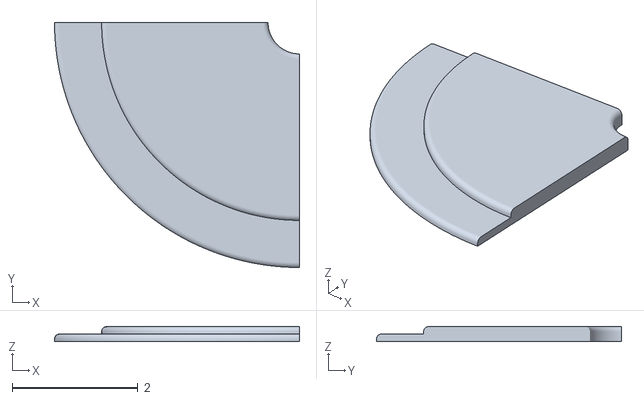
[picture p112: CAD file, 2018-05-24]
3D Model/10in_base_quarter.stl
3.90 x 3.90 x 0.236
