mzilon/Elder-Care-AI/3D Model/bottom_back_center.stl

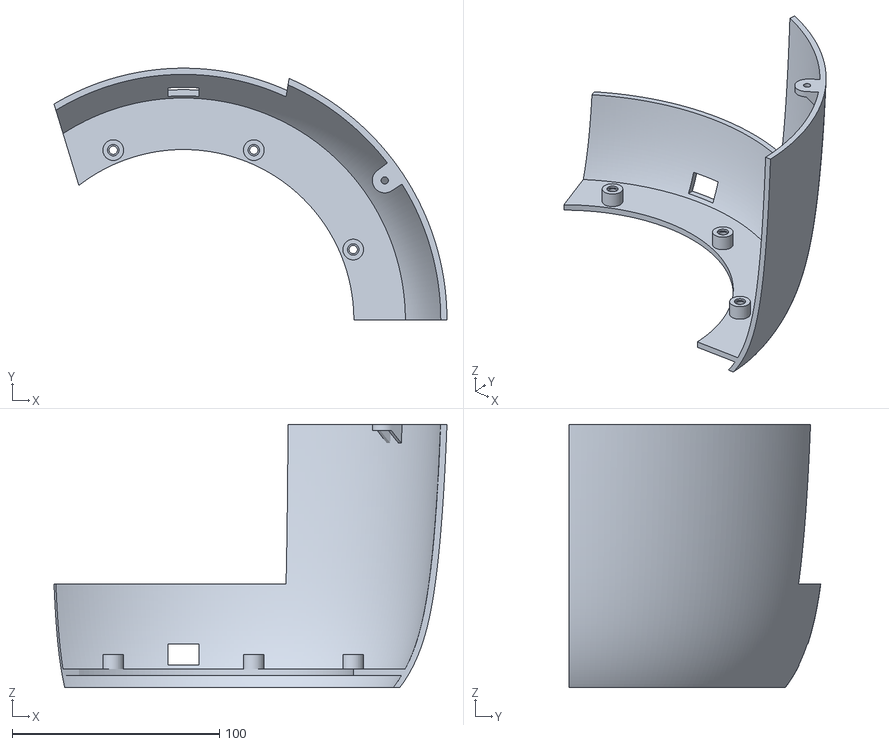
[picture p113: CAD file, 2018-05-24]
3D Model/bottom_back_center.stl
189.4 x 121.3 x 127.0
