mzilon/Elder-Care-AI/3D Model/bottom_front_right.stl

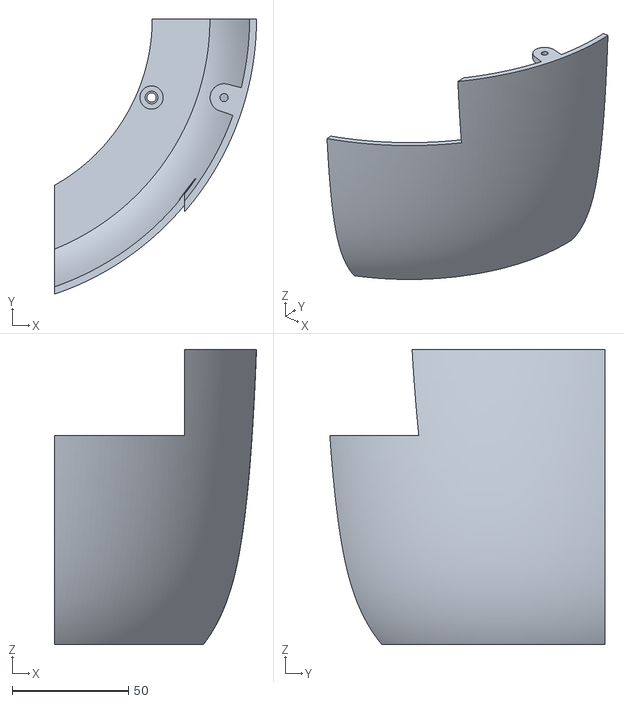
[picture p114: CAD file, 2018-05-24]
3D Model/bottom_front_right.stl
87.0 x 118.6 x 127.0
