mzilon/Elder-Care-AI/3D Model/bottom_back_components.stl

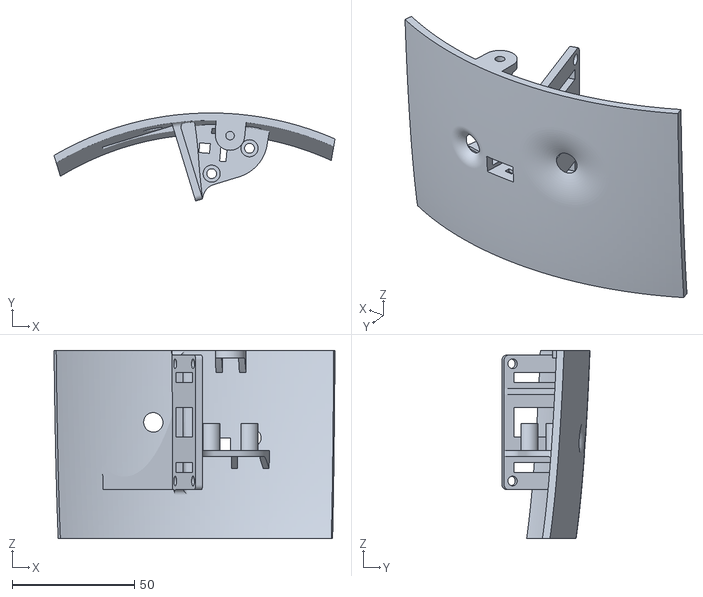
[picture p115: CAD file, 2018-05-24]
3D Model/bottom_back_components.stl
115.1 x 36.0 x 77.0
