mzilon/Elder-Care-AI/(list of files, cad)

Other CAD files:
3D Model/top_front_left.stl
3D Model/top_back_mid_left.stl
